grupo-tc-volcan/TP7/Informe/informe.tex

% Se incluye el preambulo del trabajo
\input{./preamble.tex}

% Se agrega el titulo o caratula del trabajo

% Se crea el documento y agregan los ejercicios
\begin{document}

	% Crear y configurar el titulo/caratula del informe
	\title{
		\normalfont \normalsize \textsc{Instituto Tecnol\'ogico de Buenos Aires} \\ [25pt]
		\huge Trabajo Pr\'actico Final\\
		\author{
			\\Grupo 1:\\\\Farall, Facundo David\\Gaytan, Joaqu\'in Oscar\\Kammann, Lucas\\Maselli, Carlos Javier\\M\"uller, Malena \\ \\ \\ \\
			Profesores: \\\\ Jacoby, Daniel Andrés\\Belaustegui Goitia, Carlos\\Iñaki Iribarren, Rodrigo \\ \\ \\ 
		} 		
		\text{Teor\'ia de Circuitos - 2019}
	}
	\pagenumbering{arabic}
	\maketitle
	\newpage

	% Se agrega el indice con el contenido del trabajo
	\tableofcontents

	\newpage
	\input{./ej1.tex}
	\newpage

\end{document}
