grupo-tc-volcan/TP7/Informe/informe.pdf

Instituto Tecnologico de Buenos Aires ´

# Trabajo Práctico Final Teoría de Circuitos - 2019

Grupo 1:

Farall, Facundo David
Gaytan, Joaquín Oscar
Kammann, Lucas
Maselli, Carlos Javier
Müller, Malena

Profesores:

Jacoby, Daniel Andrés
Belaustegui Goitia, Carlos Iñaki Iribarren, Rodrigo

21 de noviembre de 2019

## Índice

1. Resumen | 3
2. Introducción teórica | 3
3. Diseño del filtro | 3
4. Simulaciones y verificación | 8
5. Mediciones y resultados obtenidos | 8
6. Conclusiones | 8

## 1. Resumen

Este trabajo consiste en la realización de un filtro que cumpla con las siguientes especificaciones pautadas:

| fa | | 10kHz
| fp | | 13, 75kHz
| Aa | | 45dB
| Ap | | 1dB
Rango dinámico | 45dB

Tabla 1: Especificaciones del filtro pasa altos a realizar.

## 2. Introducción teórica

## 3. Diseño del filtro

### 3.1. Obtención de polos, ceros y Q a partir de la aproximación de Legendre

La finalidad de implementar un filtro a partir de una aproximación es adquirir presición y selectividad, como lo son las especificaciones de la tabla 1. Al aumentar la selectividad de un filtro, el mismo deja de poder ser realizado con un solo filtro de orden 1 ó 2, y es así como surge la necesidad de usar un filtro de un orden mayor. Para esto, existen distintas aproximaciones que permiten no solo realizar un filtro de orden mayor, si no que además brindan la posibildiad de realizar un filtro de orden mayor a dos a partir de la conexión en cascada de varios filtros de orden 2 ó 1, cuya cantidad depende del orden del circuito completo. Con la finalidad de cumplir la plantilla a partir de los valores de la tabla 1, se tomó un margen en el momento de utilizar la aproximación de Legendre, siendo los parámetros usados, los siguientes:

| fa | | 10kHz
| fp | | 13, 75kHz
| Aa | | 50dB
| Ap | | 0, 5dB
Rango dinámico | 45dB

Tabla 2: Especificaciones usadas en la plantilla.

Además, se restringió el valor de los Q de forma que sean menores a 10 para que todas las etapas puedan ser realziadas sin muchos problemas de ajuste. Es así como se obtuvo que el filtro debía ser de orden 11, con los siguientes polos y ceros y sus respectivos Q, a partir de los cuáles luego se determinó que tipo de
celda implementar para formar distintas etapas de segundo orden.
Singularidad | frecuencia (kHz) | Q | Angulo (rad) | Parte real (kHz) | Parte imaginaria(kHz) ´
Polo complejo conjugado | 13, 46 | 9, 93 | 1, 52 | 0, 68 | ±13, 44
Polo complejo conjugado | 14, 55 | 3, 12 | 1, 41 | 2, 33 | ±14, 36
Polo complejo conjugado | 17, 00 | 1, 65 | 1, 26 | 5, 15 | ±16, 21
Polo complejo conjugado | 21, 65 | 1 | 1, 05 | 10, 82 | ±18, 75
Polo complejo conjugado | 29, 56 | 0, 63 | 0, 65 | 23, 46 | ±17, 99
Polo real simple | 36, 04 | 0, 5 | 0 | 36, 04 | 0
11 Ceros | 0 | - | 0 | 0 | 0

Tabla 3: Polos y ceros desnormalizados de la H(s).

En cuanto a los polos, como se ve en la tabla 3, hay 5 polos complejos conjugados y un polo real simple. Se trata de un filtro de orden 11. A su vez hay 11 ceros en el origen.

### 3.2. Ordenamiento de etapas y selección de celdas

Se agruparon los polos y ceros de forma que quedara primero una etapa de primer orden con el polo real simple y un cero, obteniendo un pasa altos pasivo RC, al cual se le agregó un buffer a la salida. Luego 4 etapas pasa altos medinte la implementación de la celda Sallen-Key, cada una con un par de polos (complejo conjugado) y dos ceros en el origen. Estas etapas fueron colocadas de forma que el Q de los polos queden en orden creciente (desde la entrada hacia la salida del filtro). Y finalmente, la última etapa, tambiíen pasa altos, fue realizada mediante una celda universal Fleischer-Tow debido a que contiene el par de polos complejo conjugado cuyo Q es de 9,93. La celda Sallen-Key no permite realizar filtros de un Q de este valor, mientras que la ventaja de las celdas universales es que permiten llegar a valores de Q altos (hasta 12 o 13, siendo 10 un valor hasta el cual no deberían haber inconvenientes para su ajuste). El criterio empleado de ordenar las etapas de forma que los Q de los ceros queden de forma creciente se debe a que cuanto mayor es el Q, pueden aparecer sobrepicos mas grandes que los que pueden aparecer con Q’s bajos. Si una de las primeras etapas tiene un sobrepico alto (debido a un Q grande), habrán sobrepicos con los cuales la siguiente etapa podría saturar si el sobrepico tiene un valor de tesnión mayor al máximo con el que la siguiente etapa puede funcionar correctamente. Si no sucediera esto, igual disminuiría el rango dinámico ya que la tensión máxima de entrada disminuiría tambiíen.

### 3.2.1. Celda Fleischer-Tow

### 3.2.2. Función transferencia y parámetros

H(s) genérica | ω0 | Q

−

R8
R6

s

2+

R8
R6R1C1

−

R8
R4R7C1
s+

R8
R3R5R7C1C2
s

2+ 1
R1C1

s+

R8
R2R3R7C1C2

q R8

| R2R3R7C1C2

R1C1

q R8

| | R2R3R7C1C2

Tabla 4: Expresiones genéricas de la celda Fleischer-Tow.

Salida | Condiciones | H(s) | G
ωp | Q | ωz
HP | R5 = ∞ | −
| | R8 R6 s
| | 2

s

2+ | 1
| | R1C1 s+

R8

| | R2R3R7C1C2 | − R8 R6

Tabla 5: Características de la celda Fleischer-Tow.

### 3.2.3. Sensibilidades

| ω0 | Q | GLP | GBP | GHP | GBR
R1 | 0 | 1 | 0 | 1 | 0 | 0
R2 | −
| 1
| 2 | −
| | 1
| | 2 | 1 | 0 | 0 | 1
R3 | −
| 1
| 2 | −
| | 1
| | 2 | 0 | 0 | 0 | 0
R4 | 0 | 0 | 0 | −1 | 0 | 0
R5 | 0 | 0 | −1 | 0 | 0 | −1
R6 | 0 | 0 | 0 | 0 | −1 | 0
R7 | −
| 1
| 2 | −
| | 1
| | 2 | 0 | −1 | 0 | 0
R8 | 1
| 2 | 1
| | 2 | 0 | 1 | 1 | 0
C1 | −
| 1
| 2 | 1
| | 2 | 0 | 0 | 0 | 0
C2 | −
| 1
| 2 | −
| | 1
| | 2 | 0 | 0 | 0 | 0

Tabla 6: Sensibilidades de la celda Fleischer-Tow

### 3.3. Selección de componentes

### 3.3.1. Primera etapa: Filtro pasa altos - CR

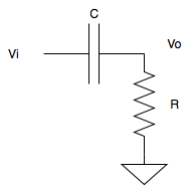
[picture p17: figure]

Figura 1: Filtro pasa altos CR

Componentes
R(Ω) | 10k
C(F) | 1n

Tabla 7: Valores elegidos para los componentes de la primera etapa.

### 3.3.2. Segunda etapa: Filtro pasa altos - Sallen-Key


Figura 2: Filtro pasa altos con celda Sallen-Key

Los valores de los componentes elegidos para esta etapa, correpsondientes a la figura 2 y a los valores de Q y de frecuencias de polos y ceros de la tabla 3 son los siguientes:

Componentes
Ra(Ω) | 10k
Rb(Ω) | 24,23k
R1(Ω) | 5,38
R2(Ω) | 5,38
C1(F) | 1n
C2(F) | 1n

Tabla 8: Valores elegidos para los componentes de la segunda etapa.

Para todas las celdas Sallen-Key se eligieron los componentes mediante el método de componentes iguales.

### 3.3.3. Tercera etapa: Filtro pasa altos - Sallen-Key

Los valores para esta celda correspondientes a la imagen 2 son los siguientes:

Componentes
Ra(Ω) | 10k
Rb(Ω) | 10k
R1(Ω) | 7,35
R2(Ω) | 7,35
C1(F) | 1n
C2(F) | 1n

Tabla 9: Valores elegidos para los componentes de la tercera etapa.

### 3.3.4. Cuarta etapa: Filtro pasa altos - Sallen-Key

Los valores para esta celda correspondientes a la imagen 2 son los siguientes:

Componentes
Ra(Ω) | 10k
Rb(Ω) | 7,17k
R1(Ω) | 9,36
R2(Ω) | 9,36
C1(F) | 1n
C2(F) | 1n

Tabla 10: Valores elegidos para los componentes de la cuarta etapa.

### 3.3.5. Quinta etapa: Filtro pasa altos - Sallen-Key

Los valores para esta celda correspondientes a la imagen 2 son los siguientes:

Componentes
Ra(Ω) | 10k
Rb(Ω) | 5,95k
R1(Ω) | 10,94
R2(Ω) | 10,94
C1(F) | 1n
C2(F) | 1n

Tabla 11: Valores elegidos para los componentes de la quinta etapa.

### 3.3.6. Sexta etapa: Filtro pasa altos - Flesicher-Tow


Figura 3: Celda Fleischer-Tow

Los valores para esta celda correspondientes a la imagen ?? son los siguientes:

Componentes
R1(Ω)
R2(Ω)
R3(Ω)
R4(Ω)
R5(Ω)
R6(Ω)
R7(Ω)
R8(Ω)
C1(F)
C2(F)

Tabla 12: Valores elegidos para los componentes de la sexta etapa.

## 4. Simulaciones y verificación

## 5. Mediciones y resultados obtenidos

## 6. Conclusiones
