grupo-tc-volcan/TP7/Diseño/polez_zeros_legendre.xlsx

Sheet: Conf. 1
STAGE | Pole freq [Hz] | Pole Q | Pole angle (rad) | Real [Hz] | Imag [Hz]
1 | 13499.5 | 9.06 | 1.52 | 745.006 | 13478.927 | 13499.5
2 | 14863.92 | 2.82 | 1.39 | 2635.447 | 14628.415 | 14863.92
3 | 18029.39 | 1.45 | 1.22 | 6217.031 | 16923.576 | 18029.39
4 | 24255.39 | 0.84 | 0.93 | 14437.732 | 19490.404 | 24255.39
5 | 33266.82 | 0.54 | 0.39 | 30802.611 | 12565.049 | 33266.82

Sheet: Conf. 2
Pole freq [Hz] | Pole Q | Pole angle (rad) | Real [Hz] | Imag [Hz]
13303.81 | 10.43 | 1.52 | 637.767 | 13288.514 | 13303.81
14189.88 | 3.3 | 1.42 | 2149.982 | 14026.057 | 14189.88
16143.38 | 1.79 | 1.29 | 4509.324 | 15500.797 | 16143.38
19669.6 | 1.11 | 1.10 | 8860.180 | 17561.047 | 19669.6
25526.33 | 0.72 | 0.80 | 17726.618 | 18367.377 | 25526.33
32337.61 | 0.53 | 0.34 | 30507.179 | 10725.345 | 32337.61
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
