grupo-tc-volcan/TP7/Imagenes/ZIN.png

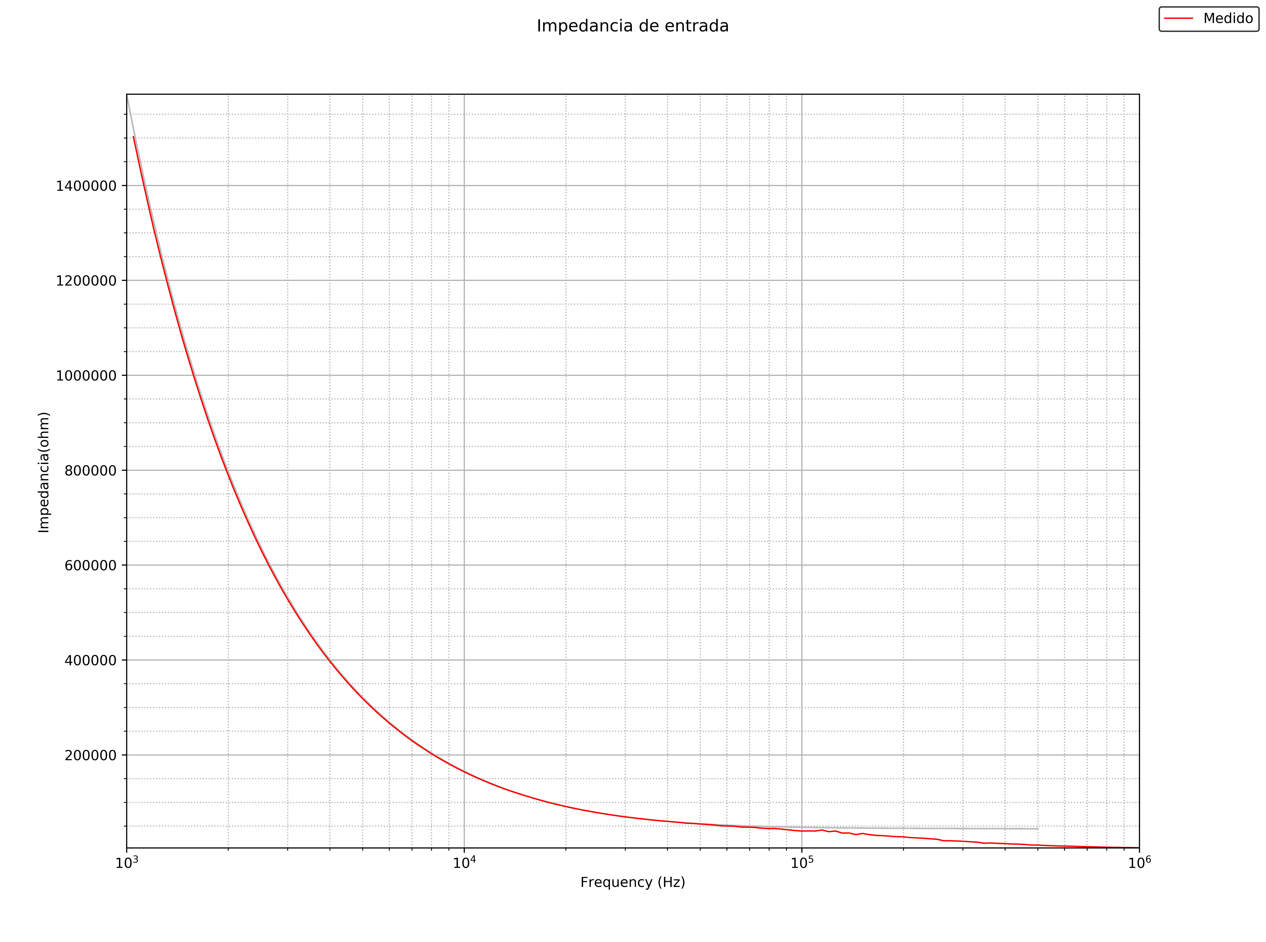
Imagenes/ZIN.png
