grupo-tc-volcan/TP7/Simulaciones/Filtro_Completo.asc

C1: cap; 1n
C2: cap; 1n
C3: cap; 100p
C4: cap; 1n
C5: cap; 1n
C6: cap; 1n
C7: cap; 1n
C8: cap; 1n
C9: cap; 1n
C10: cap; 1n
C11: cap; 1n
C12: cap; {mc(1n,0.00)}
C13: cap; {mc(1n,0.00)}
R1: res; 10937.58
R2: res; 10937.58
R3: res; 5555
R4: res; 10k
R5: res; 44160
R6: res; 10k
R7: res; 81911.76
R8: res; 5382.51
R9: res; 24230
R10: res; 10k
R11: res; 5383.51
R12: res; 10K
R13: res; 10k
R14: res; 7352.48
R15: res; 10k
R16: res; 10k
R17: res; 7352.48
R18: res; 18169
R19: res; 10k
R20: res; 9357.35
R21: res; 7173.91
R22: res; 10k
R23: res; 9357.35
R24: res; 28022
R25: res; 10K
R26: res; 10937.58
R27: res; 5954.19
R28: res; 10k
R29: res; 10937.58
R30: res; 11280
R31: res; 10K
R32: res; {mc(100k,0.0)}
R33: res; {mc(1k,0.01)}
R34: res; {mc(117411.97,0.00)}
R35: res; {mc(2400.42,0.01)}
R36: res; {mc(851.7,0.01)}
R37: res; {mc(3355.95,0.01)}
R38: res; {mc(100k,0.01)}
U1: TL08X
U2: TL08X
U3: TL08X
U4: TL08X
U5: TL08X
U6: TL08X
U7: TL08X
U8: TL08X
U9: TL08X
U10: TL08X
U11: TL08X
U12: TL08X
U13: TL08X
U14: TL08X
V1: voltage; 15
V2: voltage; 15
V3: voltage; ""; AC 1
V4: voltage; ""; AC 1
Named nets: 0, +vcc, -vcc
.ac dec 100 1k 500k
.step param run 1 20 1
