grupo-tc-volcan/TP7/(list of files, drawings)

Other design files:
Altium/filtroFinal/Array.SchDoc
Altium/filtroFinal/Filtro2.PcbDoc
Altium/filtroFinal/filtroFinal.PrjPcb
Altium/filtroFinal/filtroFinal.SchDoc
Altium/filtroFinal/finalFilter2.SchDoc
Altium/filtroFinal/finalFilter.SchDoc
Altium/filtroFinal/sallenKey_2.PcbDoc
Altium/filtroFinal/sallenKeyHP.PcbDoc
Altium/fleischerTow.PrjPCB
