grupo-tc-volcan/TP7/(commit log)

2019-11-18 agregados archivos de drive
    [polez_zeros_legendre.xlsx, seleccion_componentes_sk.xlsx]
2019-11-18 altium Fleischer Tow
    [fleischerTow.PrjPCB]
2019-11-19 agregado esquematico sallen key
    [filtroFinal.PrjPcb, filtroFinal.SchDoc]
2019-11-19 routeo sallen key terminado
    [Array.SchDoc, Filtro2.PcbDoc, filtroFinal.PrjPcb, filtroFinal.SchDoc, finalFilter.SchDoc, finalFilter2.SchDoc, polez_zeros_legendre.xlsx, sallenKeyHP.PcbDoc]
2019-11-19 agreados paralelos a divisores de tension
    [filtroFinal.SchDoc, sallenKey_2.PcbDoc]
2019-11-20 added circuito final y dise~no
    [seleccion_componentes_sk_conf4.xlsx]
2019-11-28 added cosas
    [ALL.csv, FIFTH.csv, FIRST.csv, FOURTH.csv, INPUT_Z.csv, SECOND.csv, THIRD.csv, UNIVERSAL.csv]
2019-11-28 ESAS COSITAS RICAS LAS QUIERO
    [ALL.csv, FIFTH.csv, FIRST.csv, FOURTH.csv, INPUT_Z.csv, SECOND.csv, THIRD.csv, UNIVERSAL.csv]
